araschke001-commits/RGB-Keyboard/README.md

# RGB-Keyboard
A keyboard that lights up in any color. The colors can also have effects, like a rainbow across the entire keyboard or a wave from the key pressed.

I made this so I could have an RGB keyboard that I can use for typing code and so it looked cool.

## Schematic
The schematic is in 3 pages, the Raspberry Pi Pico,  the switches, the LEDs.

Page 1:
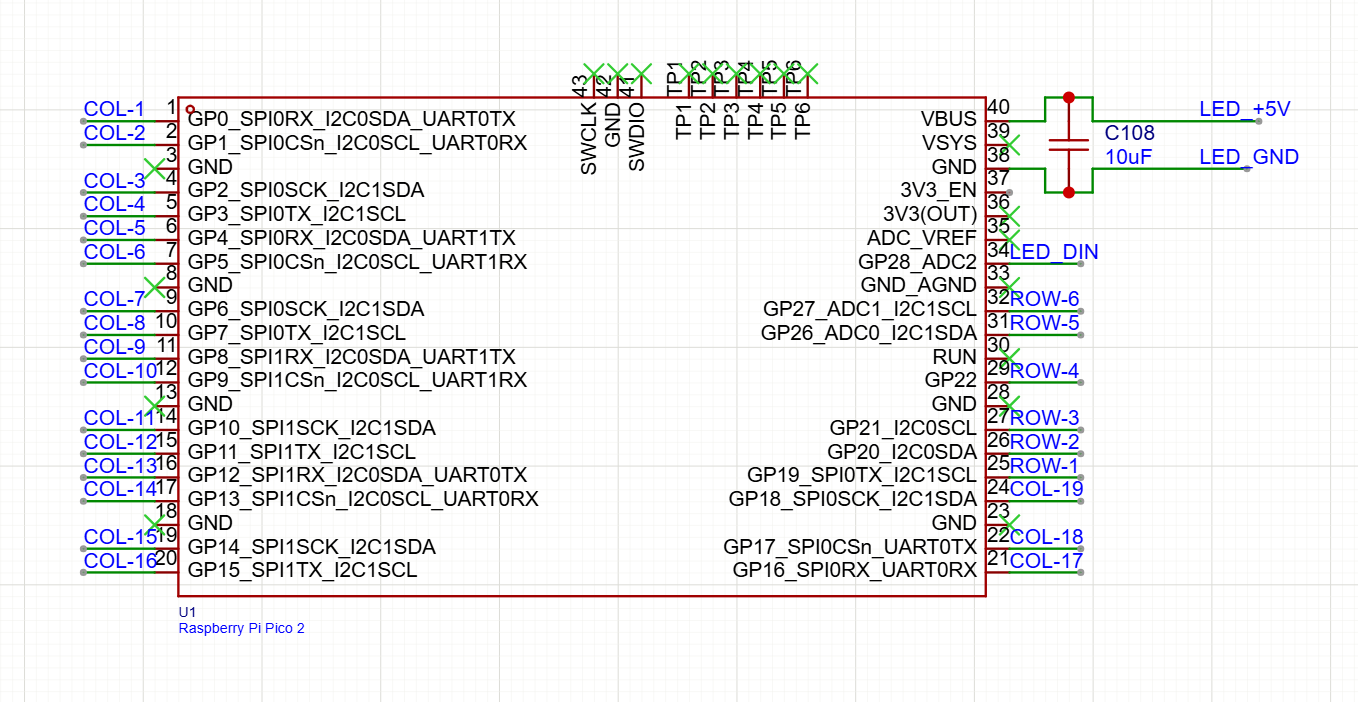
[picture p1: Pictures/Screenshot 2026-10-11 215843.png]
page 1


Page 2:
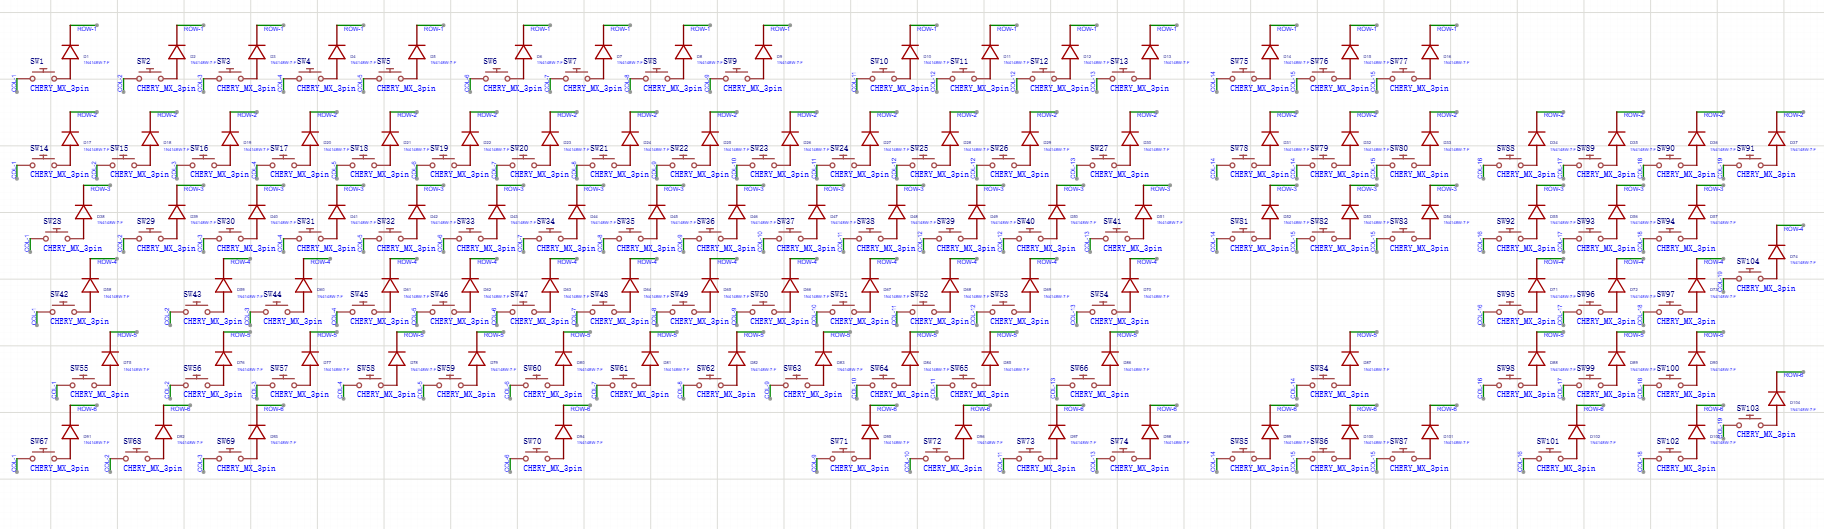
[picture p2: Pictures/Screenshot 2026-10-11 215909.png]
page 2


Page 3:
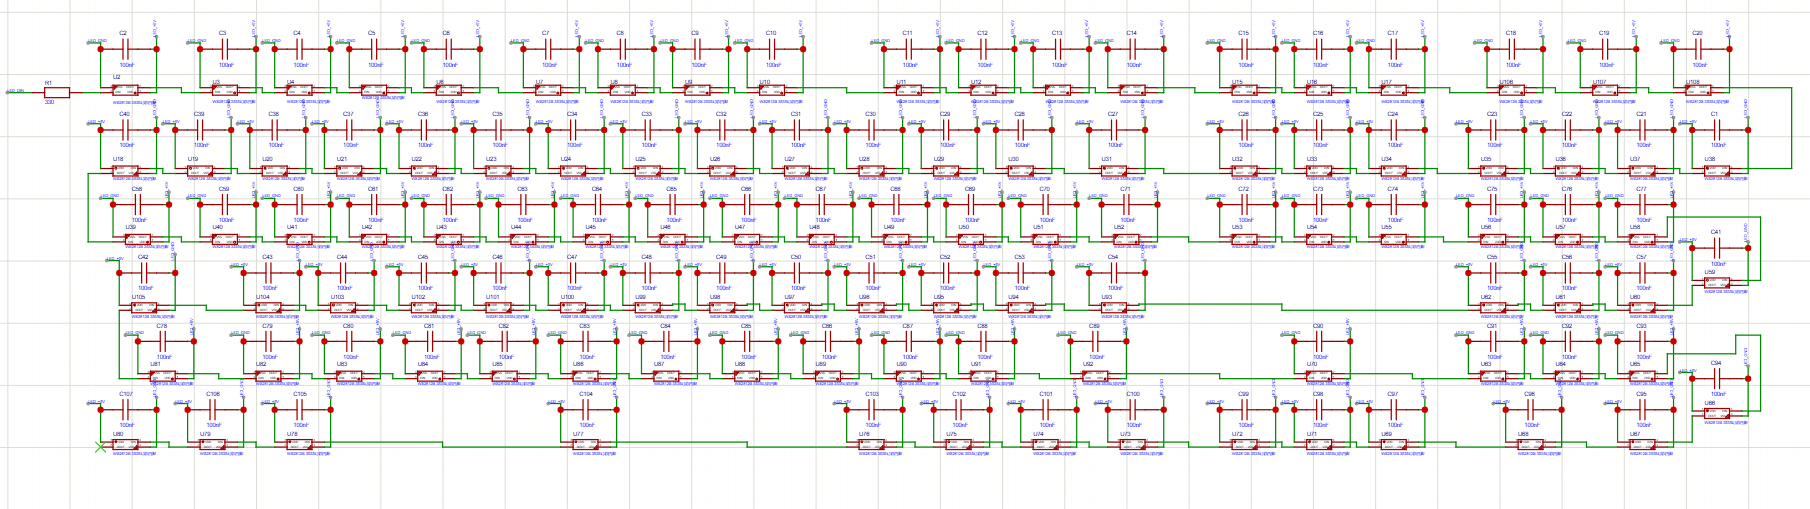
[picture p3: Pictures/Screenshot 2026-10-11 215933.png]
page 3


## PCB

PCB:
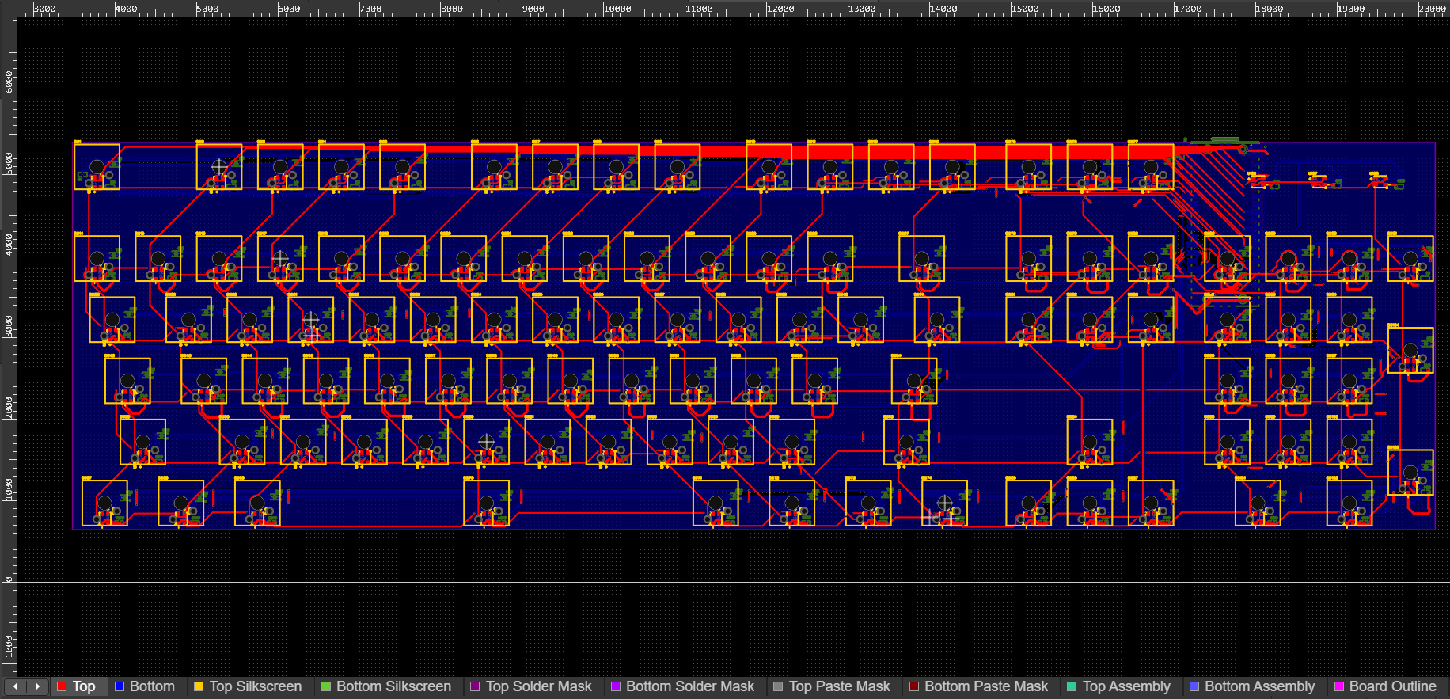
[picture p4: Pictures/Screenshot 2026-10-11 215807.png]
PCB


## 3d Render

The Onshape link to this project is [here](https://cad.onshape.com/documents/bef98f37e404cedfbf342dc0/w/166404571d869c1e016b182f/e/b0c13dd24791b61a15dc45c6).

3d:
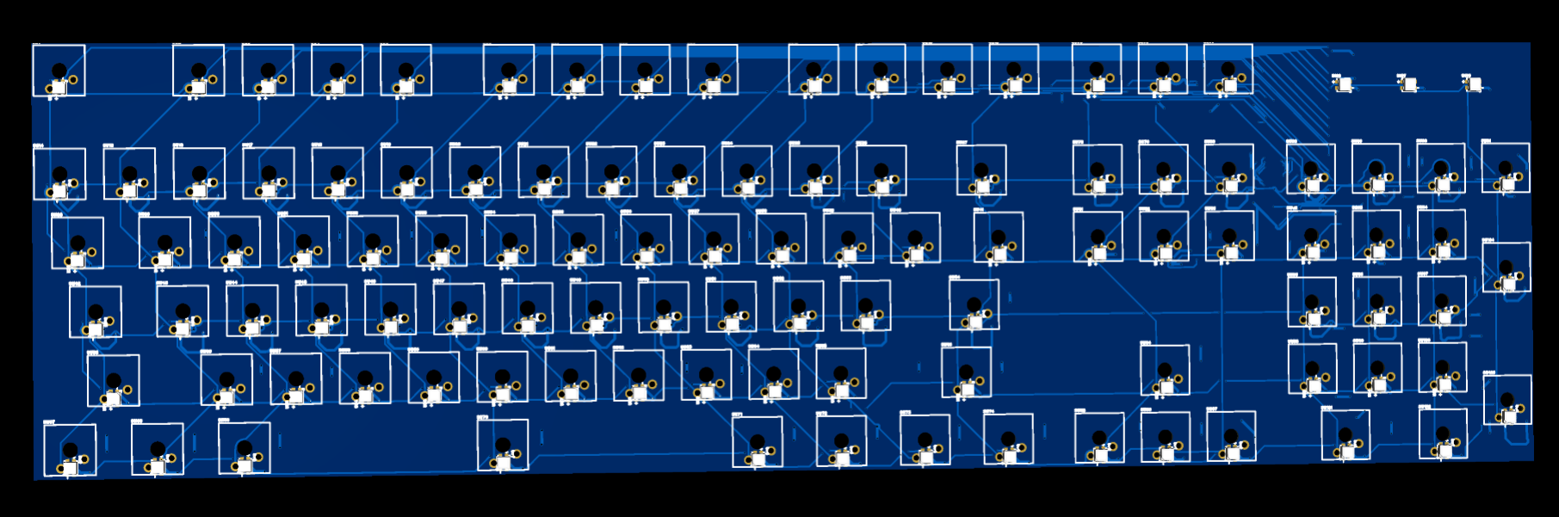
[picture p5: Pictures/Screenshot 2026-10-11 220211.png]
3d


Assembly with switches and keycaps:
Switches & Keycaps

## Reviewer Note(s)

I will purchase the keycaps and stabilizers for my project along with Week 2, in which I am making the [enclosure for my keyboard](https://github.com/araschke001-commits/RGB-Keyboard-Enclosure), along with the plate for it.

In the PCB assembly on Onshape, the switches I have in the assembly are not the switches I am using for my project, but are close (the main difference is in the hole for the LED's). Instead, I am using [these](https://mechkeys.com/products/outemu-linear-tactile-silent-mechanical-keyboard-switches?variant=42713962545375). Also the keycaps should have the correct dimensions, but also I am buying them elsewhere (for week 2).
