araschke001-commits/RGB-Keyboard/Keycaps/1889208-ergonomic-keycap-set-for-cherry-mx-complete-full-size-104-key-ansi-e97d1409-b2f7-4958-9835-d11974651a11.pdf

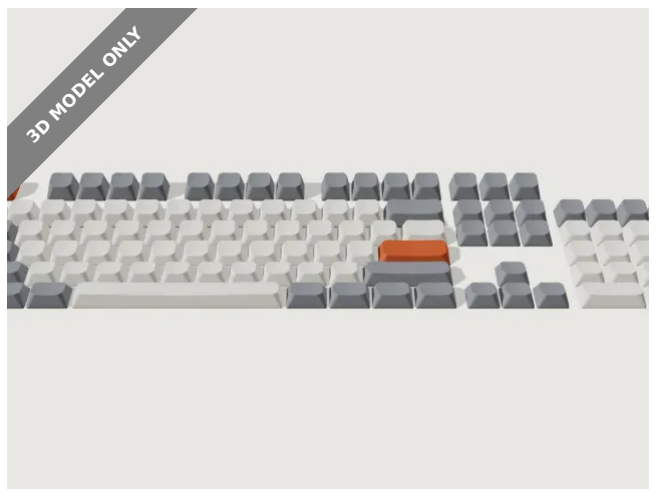
[picture p6: figure]
3D MODEL ONLY

## Summary

Complete 104-key ANSI keycap set for Cherry MX switches. Ergonomic sculpted rows, dished tops. Only 16 STLs to print.

Hobby & Makers (https://www.printables.com/model?categoryId=48) > Electronics (https://www.printables.com/model?categoryId=52)

Tags: | 3d | printed | mechanical | custom | keycap | keyboard
mx | cherry | keys | set | size | spacebar | ergonomic
sculpted | numpad | full | keycaps | 104 | ansi

A complete, ergonomic keycap set for full-size mechanical keyboards: all 104 ANSI keys, including the numpad, arrows and a 6.25u spacebar. Designed for 3D printing, with standard Cherry MX cross stems that fit MX-style switches (Cherry, Gateron, Kailh, Outemu and similar).

Why it’s comfortable

Every row leans toward your fingers. The top rows tilt back and the bottom row tilts forward, so the keyboard forms a gentle bowl around the home row. Your fingers land flat on each key with less reaching.

taarraas (https://www.printables.com/@taarraas_7176)

## Ergonomic Keycap Set for Cherry MX – Complete Full-Size 104-Key ANSI

VIEW IN BROWSER (https://www.printables.com/model/1889208-ergonomic-keycap-set-for-cherry-mx-complete-full-s)

updated 26. 10. 2026 | published 26. 10. 2026

•

Find your place by touch. Every row has its own height and angle, so you can feel which row you’re on without looking. Handy for touch typing.
Dished tops. Each key is scooped in both directions, which centers your fingertip and helps prevent slipping onto the next key.
Soft, rounded corners that grow rounder toward the top: smooth under your fingers, with a clean modern look.

Only 16 files for 104 keys. Keys in the same row and width are identical, so print each file as many times as listed:

F_1u (×16): Esc, F1–F12, Print Screen, Scroll Lock, Pause
NUM_1u (×20): 1–0 - =, Insert, Home, Page Up, Num Lock, Numpad / * -
NUM_2u (×1): Backspace
TOP_1u (×18): Q–], Delete, End, Page Down, Numpad 7 8 9 TOP_1.5u (×2): Tab, \
HOME_1u (×14): A–‘, Numpad 4 5 6
HOME_1.75u (×1): Caps Lock
HOME_2.25u (×1): Enter
BOTTOM_1u (×18): Z–/, all four arrows, Numpad 1 2 3, Numpad . BOTTOM_1.25u (×7): both Ctrl, both Win, both Alt, Menu BOTTOM_2u (×1): Numpad 0
BOTTOM_2.25u (×1): Left Shift
BOTTOM_2.75u (×1): Right Shift
BOTTOM_6.25u (×1): Space
NUMPAD_PLUS_1x2u (×1): Numpad + NUMPAD_ENTER_1x2u (×1): Numpad Enter

Specs

Height at the centre of the key: F row 9.6 mm, number row 9.1, top row 7.1, home row 6.1, bottom and space rows 6.4.
Row tilt: F 6.5°, number 4.3°, top 3.8°, home 3.5° (back edge higher); bottom and space rows 9.5° (front edge higher).
1u base 17.8 × 17.8 mm; walls 1.2 mm, top 1.3 mm.
Stem: Cherry MX cross, 4.1 × 1.31 mm, in a 5.5 mm post. Keys 2u and longer have stabilizer stems at Cherry spacing (100 mm apart on the spacebar).

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
## Model files

home_225u.stl

home_1u.stl

bottom_125u.stl

top_15u.stl

bottom_625u.stl

bottom_1u.stl

bottom_225u.stl

bottom_275u.stl

bottom_2u.stl

## License

This work is licensed under a
Creative Commons (4.0 International License)

Attribution (http://creativecommons.org/licenses/by/4.0/)

✖ | Sharing without ATTRIBUTION

num_1u.stl

num_2u.stl

home_175u.stl

numpad_enter_1x2u.stl

top_1u.stl

f_1u.stl

numpad_plus_1x2u.stl

✔ | Remix Culture allowed
✔ | Commercial Use
✔ | Free Cultural Works
✔ | Meets Open Definition
