araschke001-commits/RGB-Keyboard/Pictures/Screenshot 2026-10-31 000029.png

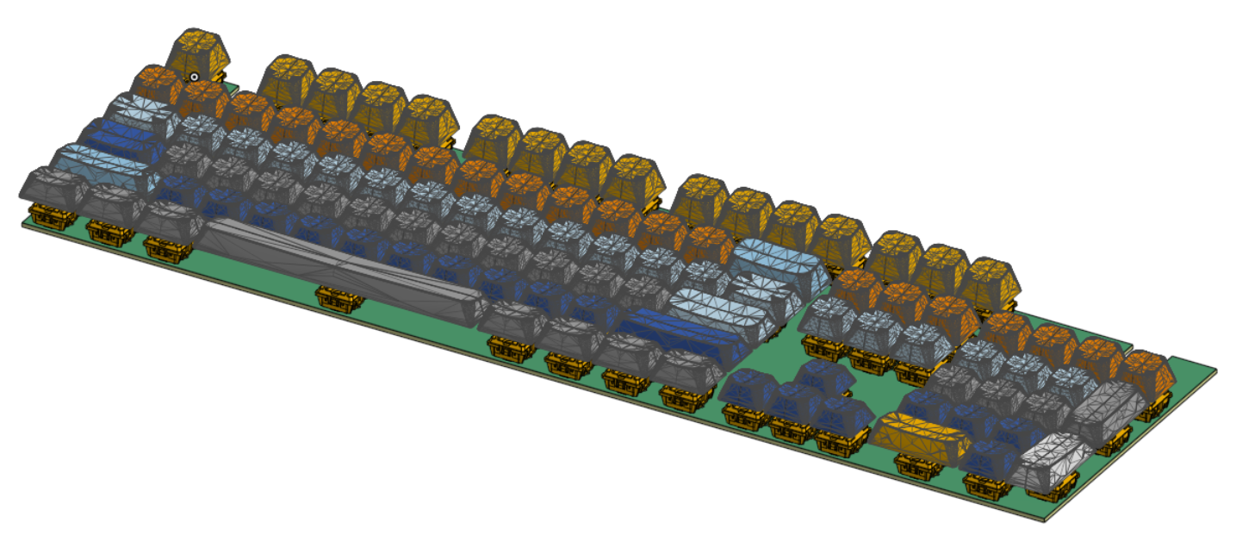
Pictures/Screenshot 2026-10-31 000029.png
