araschke001-commits/RGB-Keyboard/BOM.md

# RGB Keyboard – bill of materials

<!-- Generated by Half Life from project cmuyxftc5027301rwoxqwvcgx. Edits here are overwritten on the next sync. -->
<!-- Generated: 2026-10-12T18:20:39.120Z -->

> [!NOTE]
> This parts list is mirrored from [Half Life](https://halflife.hackclub.com). Editing it here will not change the platform's copy, and the next sync overwrites this file.

| Week | Tier | Parts funding |
| --- | --- | --- |
| Week 1 | Tier 3 | $100.00 |

| Part | What it's for | Qty | Unit | Total | Vendor |
| --- | --- | --- | --- | --- | --- |
| [Raspberry Pi Pico 2 SC1631](https://www.digikey.com/en/products/detail/raspberry-pi/SC1631/24627136) | Controlling keys and LED's. | 1 | $6.12 | $6.12 | [DigiKey](https://www.digikey.com/en/products/detail/raspberry-pi/SC1631/24627136) |
| [Gateron V2 Linear Switches](https://www.amazon.com/dp/B0C2CZJQHT?plpRedirect=mhFallback&ref=clp_cat_related_p_2&th=1) | The switches for the keyboard | 1 | $25.90 | $25.90 | [Amazon](https://www.amazon.com/dp/B0C2CZJQHT?plpRedirect=mhFallback&ref=clp_cat_related_p_2&th=1) |
| [WS2812B RGB LED](https://www.aliexpress.us/item/3256811985880403.html) | RGB backlighting | 1 | $5.27 | $5.27 | [AliExpress](https://www.aliexpress.us/item/3256811985880403.html) |
| [SDYZ x XVX Doubleshot PBT Keycaps](https://www.amazon.com/SDYZ-XVX-Doubleshot-Keycaps-Percent/dp/B0DNMWDQTN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) | The keycaps to go on the switches | 1 | $13.99 | $13.99 | [Amazon](https://www.amazon.com/SDYZ-XVX-Doubleshot-Keycaps-Percent/dp/B0DNMWDQTN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) |
| [PCB (+ PCBA)](https://cart.jlcpcb.com/shopcart/cart) | The PCB the components all go on | 1 | $23.01 | $23.01 | [JLCPCB](https://cart.jlcpcb.com/shopcart/cart) |
| **Parts subtotal** | — | — | — | **$74.29** | — |
| **Tax & shipping** | — | — | — | **$28.71** | — |
| **Total** | — | — | — | **$103.00** | — |

**$3.00 over the tier's funding.** Every tier gives a fixed amount for parts, so this needs cutting back or a higher tier.
