araschke001-commits/RGB-Keyboard/BOM.csv

Item | Qty | Supplier | Cost/item | Total Cost | link
Raspberry Pi Pico 2 SC1631 | 1 | AliExpress | $6.23 | $6.23 | https://www.aliexpress.us/item/3256812694413847.html
Outemu Linear Switches | 1 | AliExpress | $20.24 | $20.24 | https://www.aliexpress.com/item/3256802192387196.html
WS2812B RGB LED | 1 | AliExpress | $5.27 | $5.27 | https://www.aliexpress.us/item/3256811985880403.html
PCB (+ PCBA) | 1 | JLCPCB | $21.02 | $21.02 | https://cart.jlcpcb.com/shopcart/cart
Estimated total shipping | 1 |  |  | $45.99
