araschke001-commits/RGB-Keyboard/Keycaps/numpad_enter_1x2u.stl

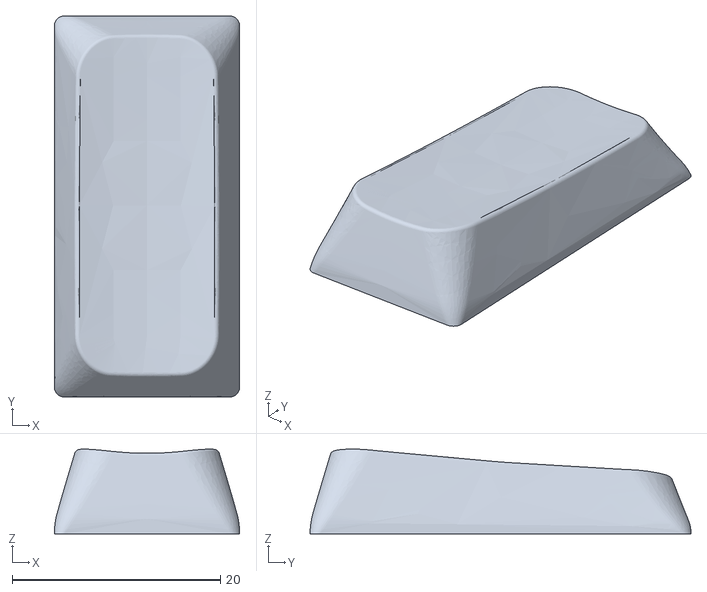
[picture p8: CAD file, 2026-10-31]
Keycaps/numpad_enter_1x2u.stl
17.8 x 36.6 x 8.14
