araschke001-commits/RGB-Keyboard/Keycaps/num_1u.stl

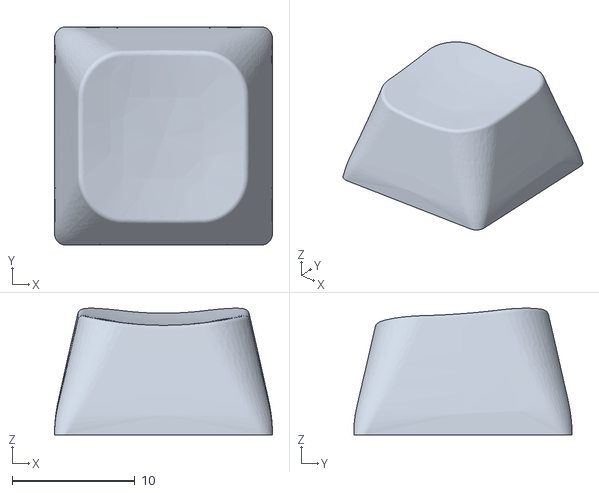
[picture p9: CAD file, 2026-10-31]
Keycaps/num_1u.stl
17.8 x 17.8 x 10.3
