araschke001-commits/RGB-Keyboard/Keycaps/bottom_1u.stl

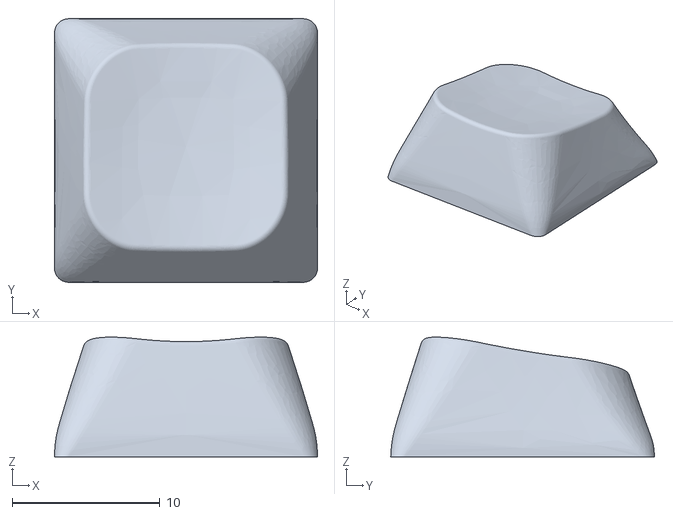
[picture p10: CAD file, 2026-10-31]
Keycaps/bottom_1u.stl
17.8 x 17.8 x 8.10
