araschke001-commits/RGB-Keyboard/Keycaps/f_1u.stl

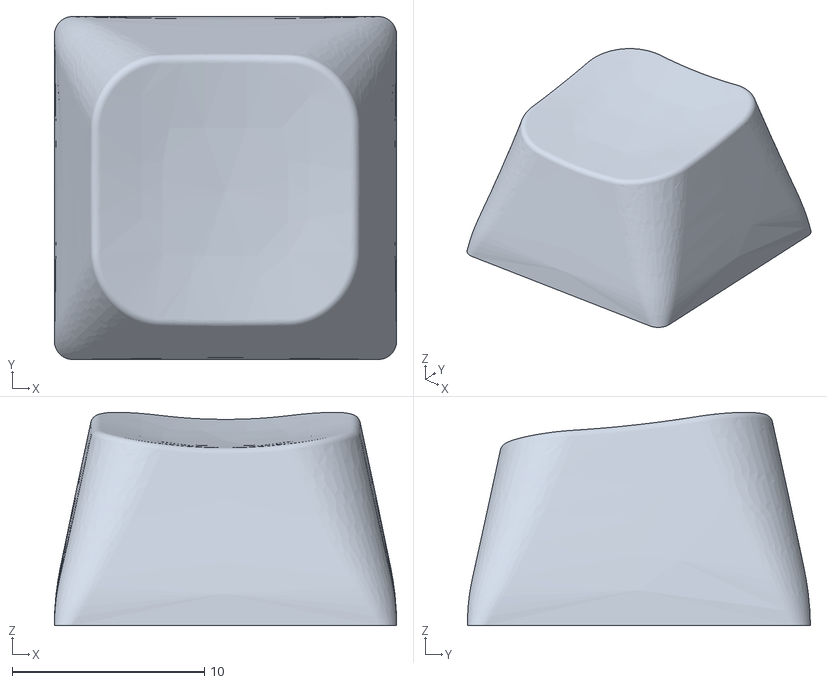
[picture p11: CAD file, 2026-10-31]
Keycaps/f_1u.stl
17.8 x 17.8 x 11.1
