araschke001-commits/RGB-Keyboard/Keycaps/top_1u.stl

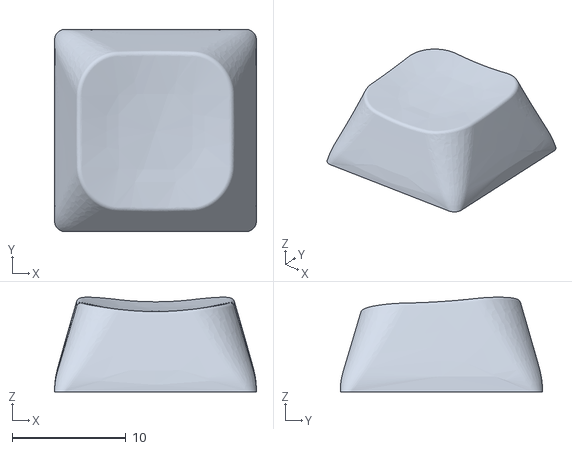
[picture p12: CAD file, 2026-10-31]
Keycaps/top_1u.stl
17.8 x 17.8 x 8.33
