araschke001-commits/RGB-Keyboard/Keycaps/home_1u.stl

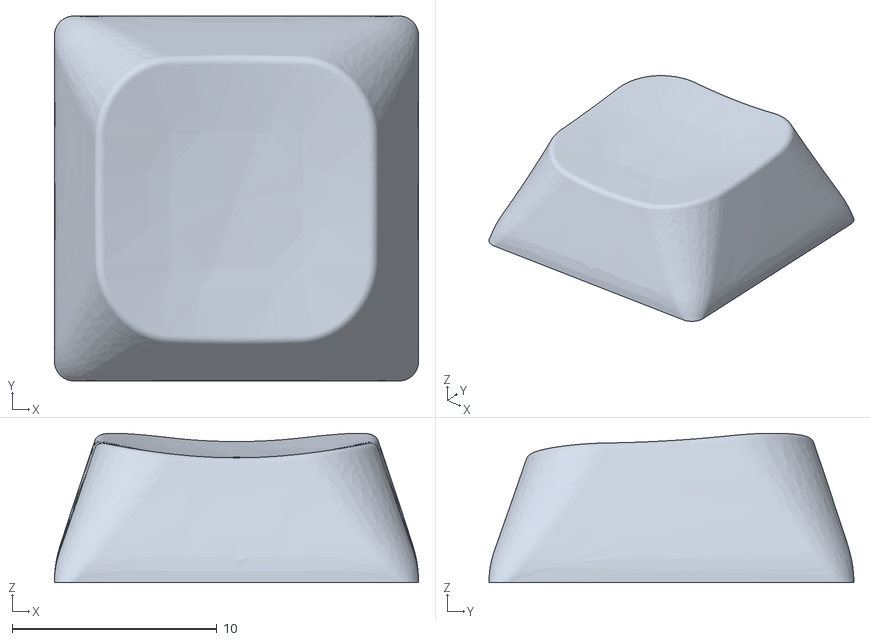
[picture p13: CAD file, 2026-10-31]
Keycaps/home_1u.stl
17.8 x 17.8 x 7.30
