araschke001-commits/RGB-Keyboard/Keycaps/bottom_125u.stl

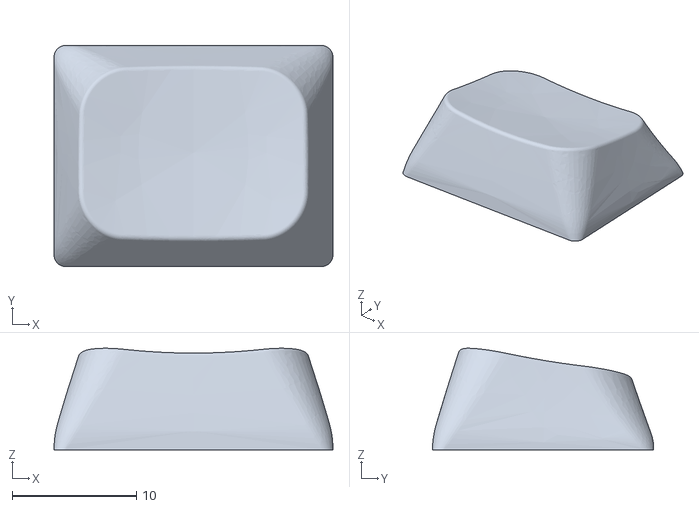
[picture p14: CAD file, 2026-10-31]
Keycaps/bottom_125u.stl
22.5 x 17.8 x 8.18
