araschke001-commits/RGB-Keyboard/Keycaps/bottom_625u.stl

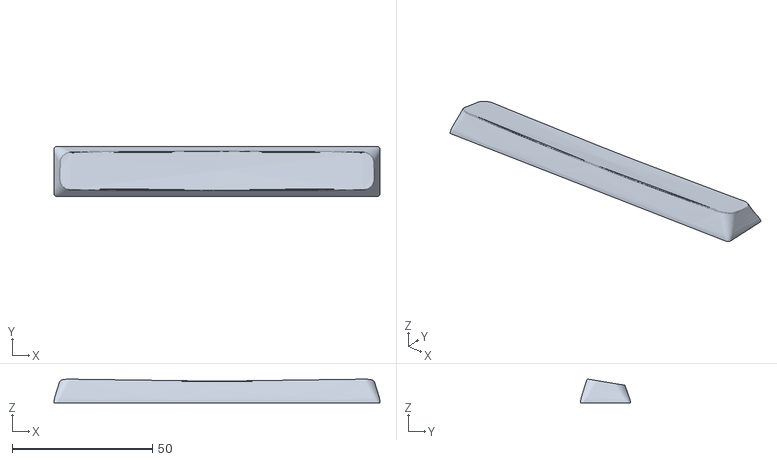
[picture p15: CAD file, 2026-10-31]
Keycaps/bottom_625u.stl
116.2 x 17.8 x 8.49
