araschke001-commits/RGB-Keyboard/Keycaps/bottom_2u.stl

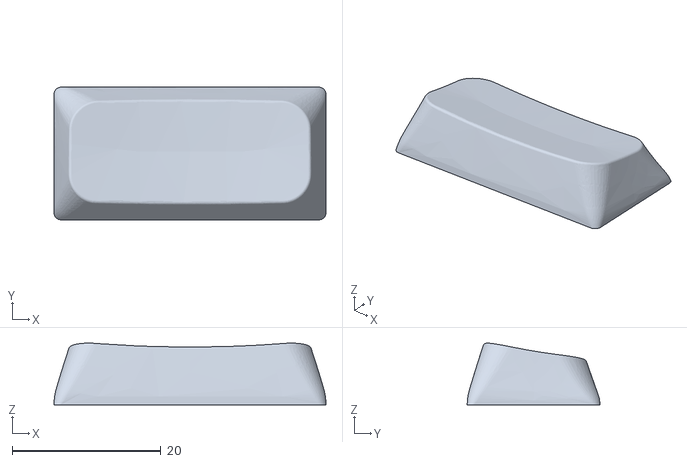
[picture p16: CAD file, 2026-10-31]
Keycaps/bottom_2u.stl
36.5 x 17.8 x 8.29
