araschke001-commits/RGB-Keyboard/Keycaps/bottom_275u.stl

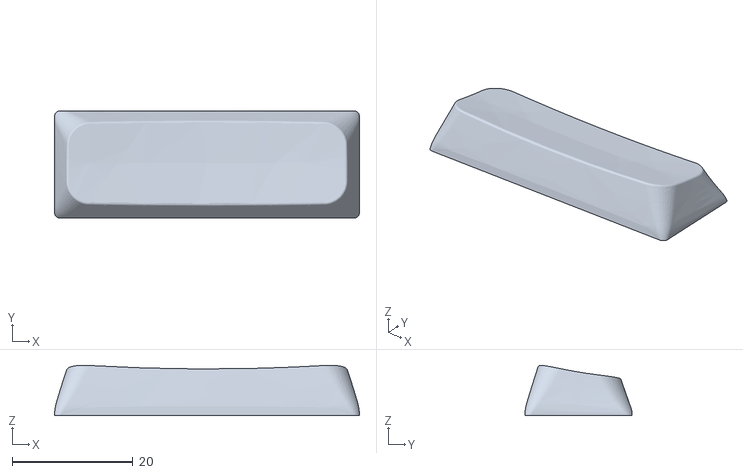
[picture p17: CAD file, 2026-10-31]
Keycaps/bottom_275u.stl
50.6 x 17.8 x 8.37
