araschke001-commits/RGB-Keyboard/Keycaps/num_2u.stl

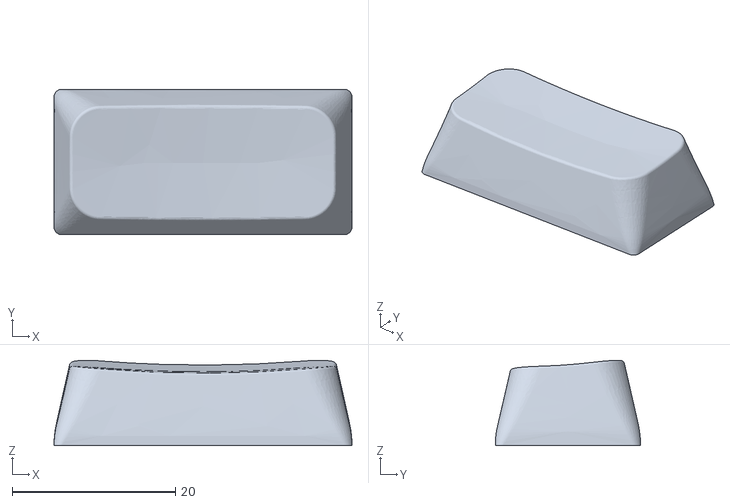
[picture p18: CAD file, 2026-10-31]
Keycaps/num_2u.stl
36.5 x 17.8 x 10.5
