araschke001-commits/RGB-Keyboard/Keycaps/home_225u.stl

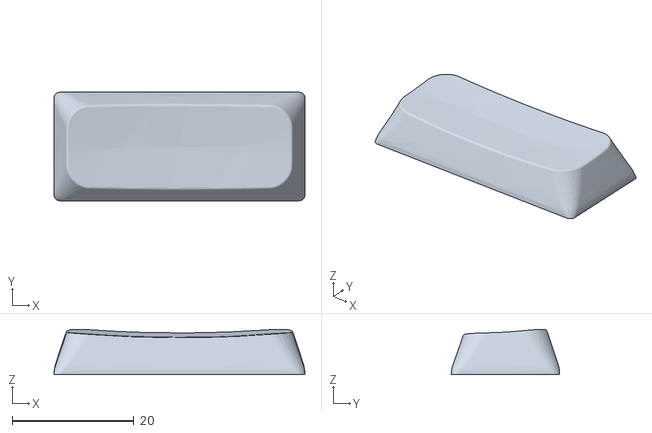
[picture p19: CAD file, 2026-10-31]
Keycaps/home_225u.stl
41.2 x 17.8 x 7.45
