araschke001-commits/RGB-Keyboard/Keycaps/bottom_225u.stl

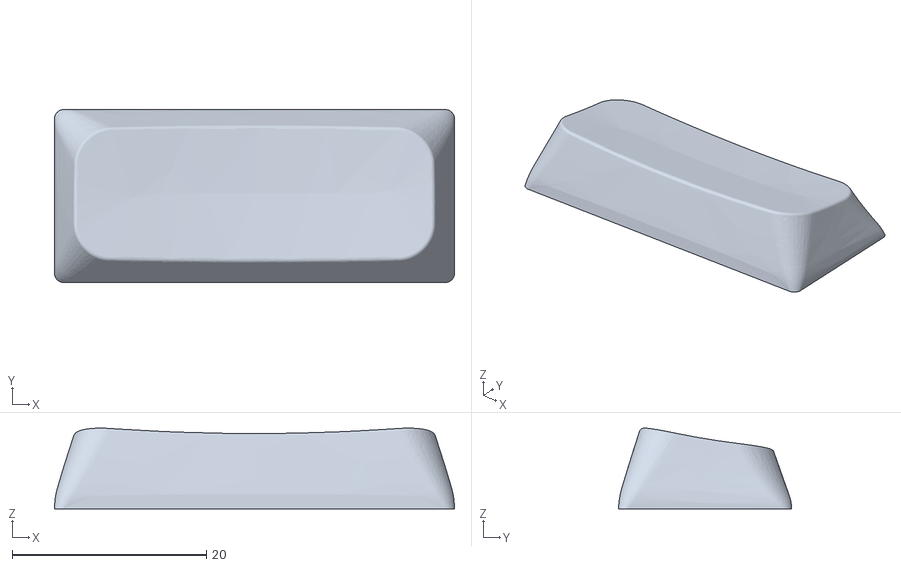
[picture p21: CAD file, 2026-10-31]
Keycaps/bottom_225u.stl
41.2 x 17.8 x 8.32
