araschke001-commits/RGB-Keyboard/Keycaps/home_175u.stl

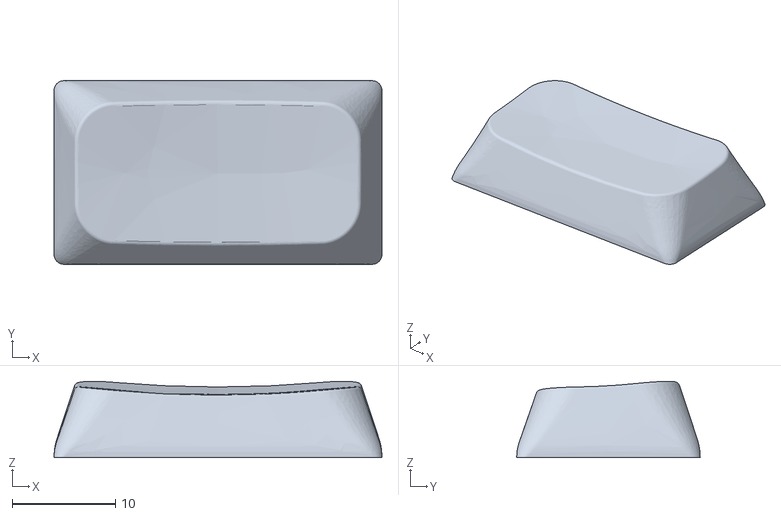
[picture p22: CAD file, 2026-10-31]
Keycaps/home_175u.stl
31.8 x 17.8 x 7.41
