araschke001-commits/RGB-Keyboard/Keycaps/top_15u.stl

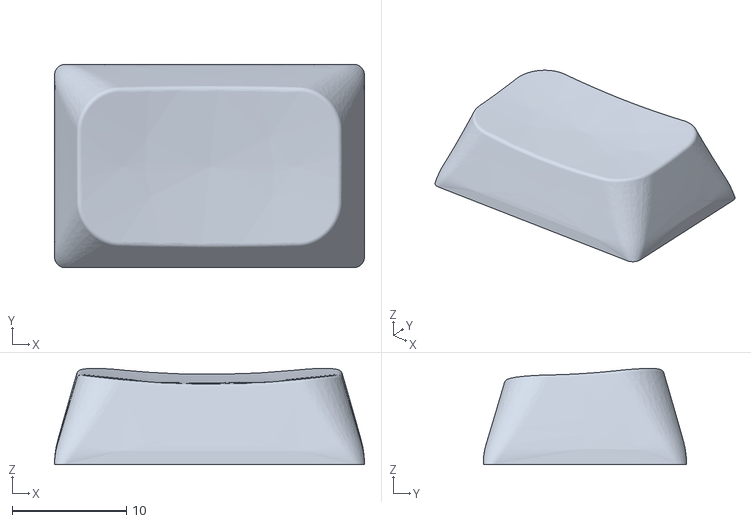
[picture p23: CAD file, 2026-10-31]
Keycaps/top_15u.stl
27.2 x 17.8 x 8.43
