araschke001-commits/RGB-Keyboard/Keycaps/R4 1.25u.3mf

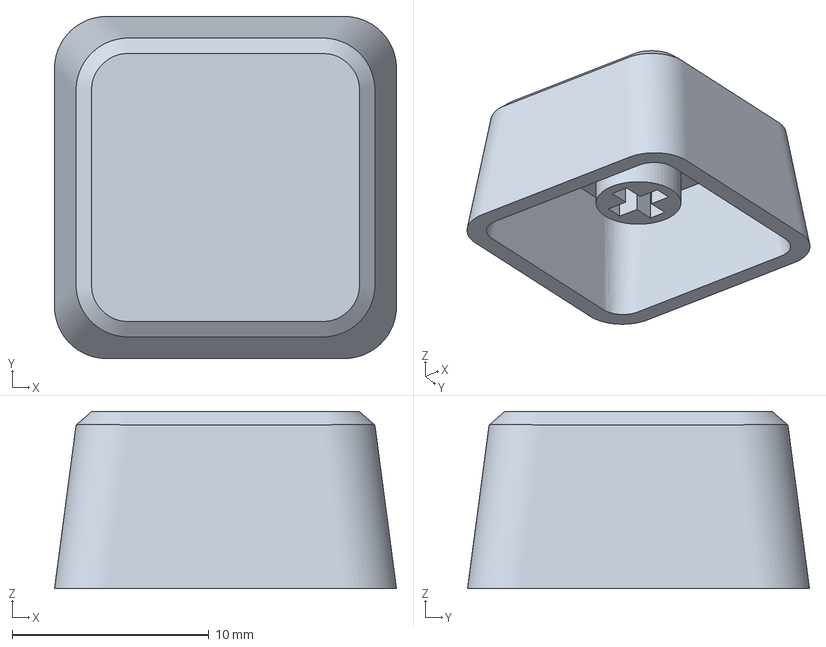
[picture p24: CAD file, 2026-10-29]
Keycaps/R4 1.25u.3mf
17.4 x 17.4 x 9.00 mm
