araschke001-commits/RGB-Keyboard/Keycaps/R1 2u 3stem.3mf

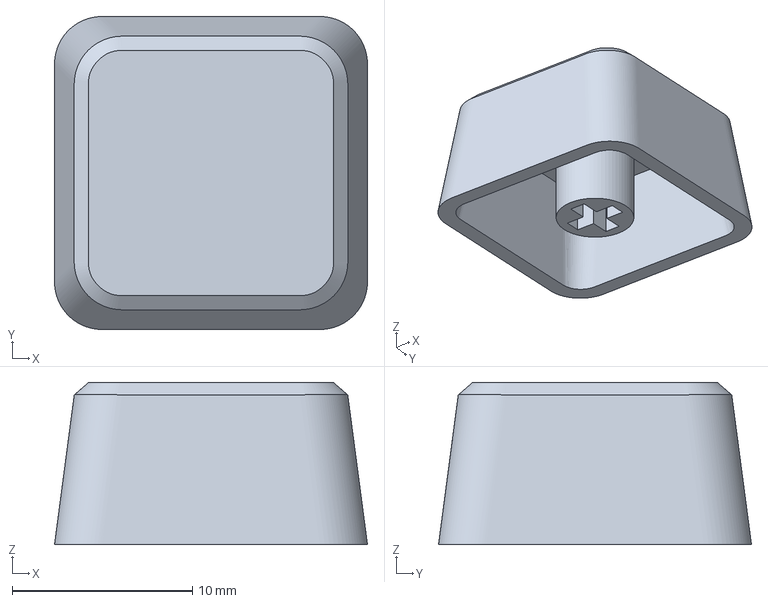
[picture p25: CAD file, 2026-10-29]
Keycaps/R1 2u 3stem.3mf
17.4 x 17.4 x 9.00 mm
