araschke001-commits/RGB-Keyboard/(list of files, cad)

Other CAD files:
Keycaps/R4 2u 3stem.3mf
Keycaps/R4 2.25u.3mf
Keycaps/R4 1u.3mf
Keycaps/R4 6.25u Spacebar.3mf
Keycaps/R2 1u.3mf
Keycaps/R2 1.5u.3mf
Keycaps/R3 1.75u.3mf
Keycaps/R3 1u.3mf
Keycaps/R4 2.75u.3mf
Keycaps/R1 1u.3mf
Keycaps/R3 2.25u.3mf
Keycaps/R2 2u 3stem.3mf
