araschke001-commits/RGB-Keyboard/JOURNAL.md

# RGB Keyboard: devlog

<!-- Generated by Half Life from project cmuyxftc5027301rwoxqwvcgx. Edits here are overwritten on the next sync. -->
<!-- Generated: 2026-10-31T05:08:51.469Z -->

> [!NOTE]
> This devlog is mirrored from [Half Life](https://halflife.hackclub.com) ([open the project](https://halflife.hackclub.com/projects/cmuyxftc5027301rwoxqwvcgx)). Editing it here will not change the platform's copy, and the next sync overwrites this file.

> A keyboard that lights up in any color. The colors can also have effects, like a rainbow across the entire keyboard or a wave from the key pressed.

| Week | Tier | Hours logged | Entries |
| --- | --- | --- | --- |
| Week 1 | Tier 3 | 27.01h | 9 |

## Contents

1. [2026-10-09: # Part Searching](#2026-10-09-part-searching)
2. [2026-10-10: Work session](#2026-10-10-work-session)
3. [2026-10-11: In addition to the timelapse, there were 2 times where I forgot to hit the record button again after taking a break. For the first one, I was editing the schematic for about 30 minutes, replacing the](#2026-10-11-in-addition-to-the-timelapse-there-were-2-times-w)
4. [2026-10-11: For the gaps in the timelapse, I was routing the wires for the LED_+5V for the first one, and for the second one, I was doing something similar, routing the wires (or tracks if you want to call them t](#2026-10-11-for-the-gaps-in-the-timelapse-i-was-routing-the-w)
5. [2026-10-25: This is the image of the changes that I was making (some of them at least):](#2026-10-25-this-is-the-image-of-the-changes-that-i-was-makin)
6. [2026-10-27: These were the changes I was trying to make:](#2026-10-27-these-were-the-changes-i-was-trying-to-make)
7. [2026-10-29: In this session, I was trying to download the models for the keycaps to make an assembly with them and the switches in Onshape. I was able to download many models for various sizes and rows of the key](#2026-10-29-in-this-session-i-was-trying-to-download-the-mode)
8. [2026-10-29: I was still trying to make an assembly with both the PCB and keycaps. Specifically, I was trying to find CAD models of similar keycaps to the ones I am buying for Week 2. This took a really long time](#2026-10-29-i-was-still-trying-to-make-an-assembly-with-both-)
9. [2026-10-31: I finished the keycaps assembly by first splitting all of the faces of the keycaps (only 1 face per keycap) so I could select the center to place it on the switch. Then I placed all of them on  the sw](#2026-10-31-i-finished-the-keycaps-assembly-by-first-splittin)

## Design

### 2026-10-09: # Part Searching

**4.5h**

# Part Searching

I searched for parts for my RGB keyboard for most the time with help from Google AI (about 3h, probably would have taken 3 weeks without AI) and the rest of the time I spent on getting started with my schematic.

For how I calculated the time I spent on this, I had 0.5h on it during one class at school, then 1h in another class (it was a workday in both and I already finished the work). Then I worked on it for about 3h at home, the only interruption being dinner. I realized that I really needed to lock in to get it finished on time, so I put in a lot of work.

## Searching for parts

For most of this, I was searching google, trying to find  what parts I would need for my keyboard and the symbol, footprint, and 3d model for those parts. The rest I spent on figuring out how it all would go together.

- First, I looked for a switch to use that would support RGB leds. I was able to find the Cherry MX2A-L1NA fairly quickly, but the tough part was finding the symbol and footprint for EasyEda to be able to use. I spent a long time searching with Google AI to find a symbol for it or at least one that was identical. It eventually led me to using a user-contributed part which I am using now. Everything looks fine for now with it, so I am hoping it does not let me down.


- Second, I looked for the leds to go with the switches. After a little while searching, I was able to find the Adafruit 2686 which seemed to go perfectly with the switches. Finding the symbol and footprint also took a long time, and I actually gave up searching and came back to it at the end. I was eventually able to find a site to download the models from, and from there I imported it into EasyEda, although basically all of Adafruit's library came with it (600+ items).


- Third, I looked for the keycaps to go on the switches. At first, I was thinking I was just going to get a set of keycaps with no design for the keyboard, but then I realized that I would need to have ones with designs and larger ones, so I looked into a keyboard set of keycaps, and found some on Amazon. I spent a while searching because I wanted them to look good, but the ones I landed on were actually the first ones I found.


- After that, I decided it was time to find a microcontroller for the project (maybe should have been my first instinct, but it seemed to work out fine). I looked for some that used C++, or QMK, but then I decided to use one that used Python (the RASPBERRY PI PICO 2 RP2350) because it seemed like a great fit for my project, I know how to use Python quite well already, and it was pretty compact. I was able to get the models for it fairly easily, although the symbol and footprint were in Kicad's format and I wasn't able to import them into EasyEda, but I just realized as I was writing this that it might be on EasyEda already, and sure enough, it is.



- Finally, after the microcontroller, I was researching how the matrix wiring for the switches and the wiring for the leds was going to work, and I realized that I would need a diode for each switch. I was able to find the diode to use with minimal effort with the help of Google, and I downloaded the models for it, but I didn't import them into EasyEda for whatever reason.


## Starting on my PCB Schematic

- First, I had to copy and paste all of the switches into close to the correct locations so I could see which switch is which and how it would work. I got a little carried away with this and spent an excessive amount of time making it look almost perfect without even using any dimensions.

- After that, I imported the RGB leds from Adafruit's library. (along with almost all the rest of it, as I stated before) Then I realized it was too big to fit with my meticulous switch spacing, so I tried to research a way to make it smaller, and then I realized it was getting late.

These are the images of my schematic before and after I got the RASPBERRY PI PICO 2 RP2350 imported:





## Summary (TL;DR)

I searched for parts for my keyboard, finding many of them, researched about how to wire the pcb, and started on my schematic.

### 2026-10-10: Work session

**5.18h**

[Timelapse](https://lookout.hackclub.com/api/media/345d3354-d071-47d1-bdd9-edf798618ec1/video.mp4)

### 2026-10-11: In addition to the timelapse, there were 2 times where I forgot to hit the record button again after taking a break. For the first one, I was editing the schematic for about 30 minutes, replacing the

**4.07h**

In addition to the timelapse, there were 2 times where I forgot to hit the record button again after taking a break. For the first one, I was editing the schematic for about 30 minutes, replacing the nets with the correct ones for half of the switches. For the second, I was placing the LED's on the PCB, which was about 20 minutes of it.

For the layout of the switches, I used an image (https://cdn.shopify.com/s/files/1/0280/3931/5529/files/full_size_1024x1024.jpg?v=1650363290) to figure out what spacing, in u's, the keys were apart from one another and then do some math to figure out the distances. Later I figured out that some of these were wrong, so I had to change them.

[Timelapse](https://lookout.hackclub.com/api/media/4a01dd50-ad74-4f39-9c27-9f7d8af11e8f/video.mp4)

### 2026-10-11: For the gaps in the timelapse, I was routing the wires for the LED_+5V for the first one, and for the second one, I was doing something similar, routing the wires (or tracks if you want to call them t

**4.93h**

For the gaps in the timelapse, I was routing the wires for the LED_+5V for the first one, and for the second one, I was doing something similar, routing the wires (or tracks if you want to call them that) for the LED_GND.

[Timelapse](https://lookout.hackclub.com/api/media/af904e0c-fd84-4517-bd0a-6f7ffc9304c4/video.mp4)

### 2026-10-25: This is the image of the changes that I was making (some of them at least):

**0.38h**

This is the image of the changes that I was making (some of them at least):


I just fixed the GPIO lines so they weren't too close to each other in this session and I just used an image for the layout of the switches when I first made it  (). Also I am making the plate and case for my PCB in Week 2, since I figured that Week 1 was the PCB and Week 2 was the enclosure, and since it said as fill-in text on the description for Week 2's project when you first make it "an enclosure for the PCB in week 1" or something like that.

[Timelapse](https://lookout.hackclub.com/api/media/d278cf1c-11ba-4a2c-a58d-bb15f2485663/video.mp4)

### 2026-10-27: These were the changes I was trying to make:

**2.38h**

These were the changes I was trying to make:


For a lot of the timelapse, I was working on changing the sites for my BOM to make it fit within the budget.

Then I worked on trying to find a way to import the keycaps to make the assembly with them and the switches. I also went on rabbit trails during this trying to first make the USB C port on the case and then trying to find a stabilizer for some of the keys.

[Timelapse](https://lookout.hackclub.com/api/media/f8692a36-e8f9-49b5-8563-428e378f3786/video.mp4)

### 2026-10-29: In this session, I was trying to download the models for the keycaps to make an assembly with them and the switches in Onshape. I was able to download many models for various sizes and rows of the key

**0.77h**

In this session, I was trying to download the models for the keycaps to make an assembly with them and the switches in Onshape. I was able to download many models for various sizes and rows of the keyboard, but then when I got them into Onshape I realized that they didn't translate (whatever that means) and so I'll figure out what to do with them tomorrow. A lot of the time was spent on trying to get the GitHub repo cloned in VS Code.

[Timelapse](https://lookout.hackclub.com/api/media/2f3e3b29-9977-4819-95c8-87b9cb094f6e/video.mp4)

### 2026-10-29: I was still trying to make an assembly with both the PCB and keycaps. Specifically, I was trying to find CAD models of similar keycaps to the ones I am buying for Week 2. This took a really long time

**1.87h**

I was still trying to make an assembly with both the PCB and keycaps. Specifically, I was trying to find CAD models of similar keycaps to the ones I am buying for Week 2. This took a really long time because AI wasn't very helpful in finding good 3d models to use and because I had to test and make sure they worked. I eventually found some on printables.com that I could use and imported them into Onshape. I also split the face on the first one to see if it would work to get a mate connector in the center of the stem.

[Timelapse](https://lookout.hackclub.com/api/media/362ffc3a-ae9f-4bd9-8d95-4d907fc76603/video.mp4)

### 2026-10-31: I finished the keycaps assembly by first splitting all of the faces of the keycaps (only 1 face per keycap) so I could select the center to place it on the switch. Then I placed all of them on  the sw

**2.93h**

I finished the keycaps assembly by first splitting all of the faces of the keycaps (only 1 face per keycap) so I could select the center to place it on the switch. Then I placed all of them on  the switch, only to realize that I wouldn't be able to make the stabilizers work for the spacebar since the hole for the plate tab was in the way. Then I had to remake the PCB for that and redo about half of the keycaps.

[Timelapse](https://lookout.hackclub.com/api/media/d40c6a8f-3a70-49f2-a02a-c7bb68a13a06/video.mp4)
