araschke001-commits/RGB-Keyboard/(commit log)

2026-10-08 Sync PCB Project from Half Life
2026-10-12 Add schematic section to README
    Added schematic section to README with details.
2026-10-12 Update README with schematic and PCB images
    Added images for schematic, PCB, and 3D render.
2026-10-12 Rename RGB Keyboard Gerbers.zip to PCB Files/RGB Keyboard Gerbers.zip
2026-10-12 Rename RGB Keyboard.epro2 to PCB Files/RGB Keyboard.epro2
2026-10-12 Add image link for Raspberry Pi Pico in BOM
    Updated the RGB Keyboard BOM with an image link for the Raspberry Pi Pico.
2026-10-12 Revise RGB Keyboard BOM with updated links
    Updated part links and formatting in the BOM.
2026-10-12 Fix formatting issues in RGB Keyboard BOM
    Updated the BOM to correct formatting and ensure proper CSV structure.
2026-10-12 Add HTML links to components in BOM
    Updated the format of the BOM to include HTML links for components.
2026-10-12 Format RGB Keyboard BOM CSV with HTML escape characters
    Updated the format of the RGB Keyboard BOM CSV file by adding HTML escape characters.
2026-10-12 Fix HTML entity encoding in RGB Keyboard BOM
    Updated the CSV file format to correct HTML entity encoding.
2026-10-12 Add links to components in BOM
    Added links to each component for easy access.
2026-10-12 Revise RGB Keyboard BOM with updated totals
    Updated the RGB Keyboard BOM to reflect new totals and added tax & shipping.
2026-10-12 Update README with reviewer note on BOM pricing
    Added a reviewer note regarding BOM pricing and project funding.
2026-10-12 Revise RGB Keyboard BOM with updated parts and totals
    Updated the RGB Keyboard BOM to reflect new pricing and components.
2026-10-12 Revise pricing and BOM notes in README
    Updated the cost details and clarified the BOM discrepancies in the README.
2026-10-13 Modify RGB Keyboard BOM with new switches and totals
    Updated the keyboard BOM to include new switch model and adjusted totals.
2026-10-19 Update Reviewer Note section in README.md
    Clarified reviewer notes regarding BOM discrepancies and funding requests.
2026-10-31 Updated README
    Updated README with keycaps assembly and reviewer note.
